nipil/atlantic-thermostat-board/LTspice/fil-pilote/capture-filpilote-arret.png

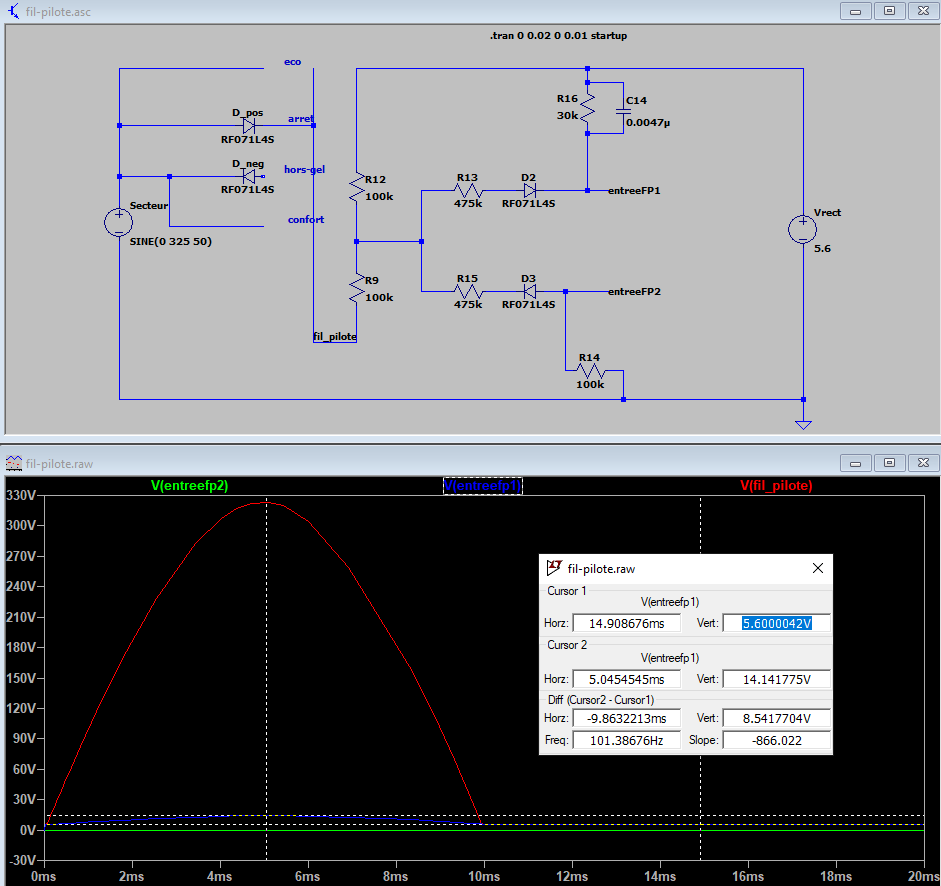
LTspice/fil-pilote/capture-filpilote-arret.png
