nipil/atlantic-thermostat-board/LTspice/fil-pilote/capture-filpilote-confort.PNG

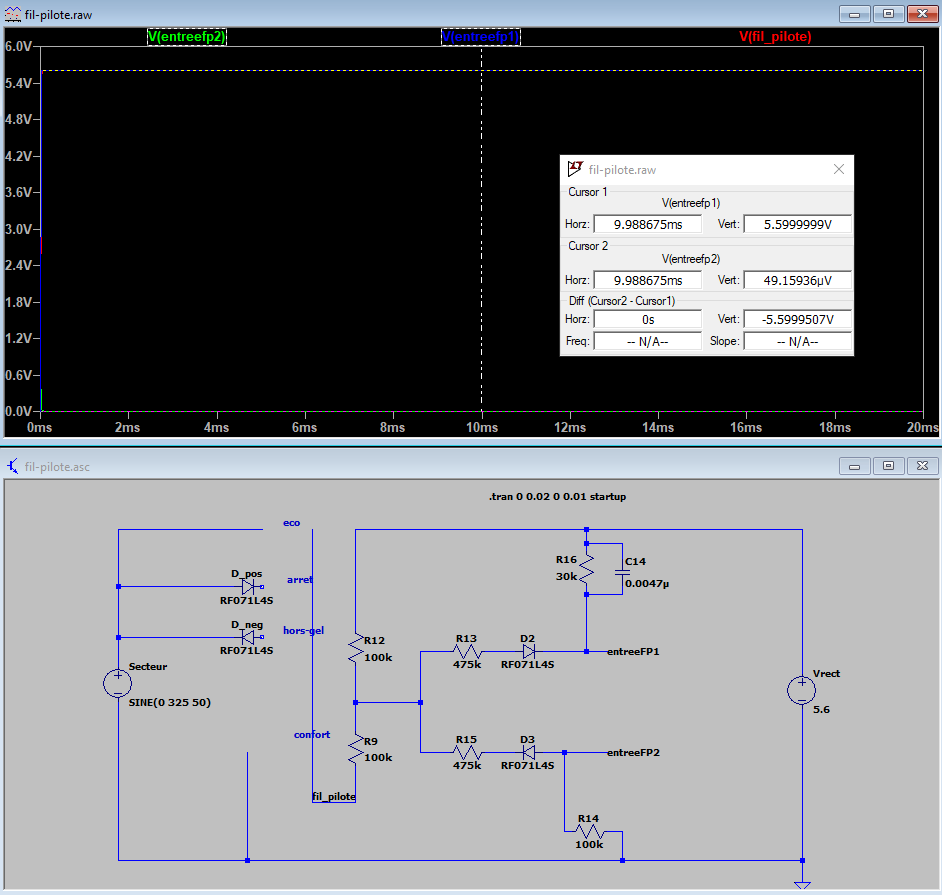
LTspice/fil-pilote/capture-filpilote-confort.PNG
