nipil/atlantic-thermostat-board/LTspice/fil-pilote/capture-filpilote-eco.PNG

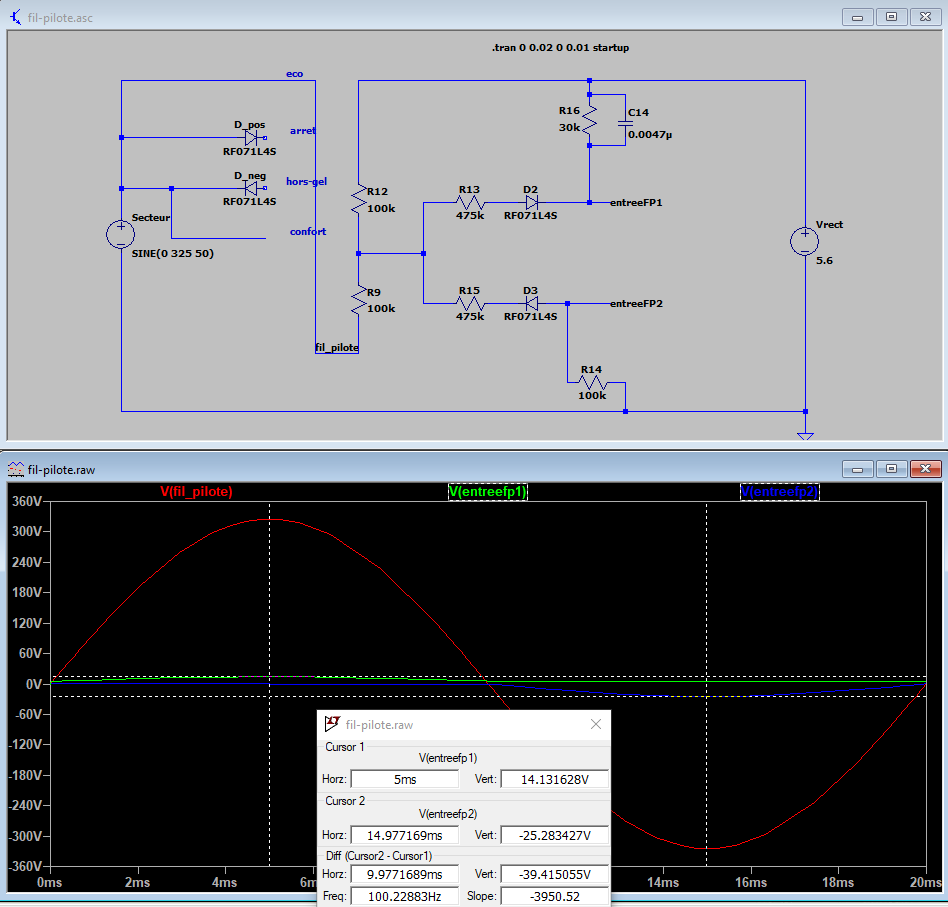
LTspice/fil-pilote/capture-filpilote-eco.PNG
