nipil/atlantic-thermostat-board/LTspice/fil-pilote/capture-filpilote-horsgel.PNG

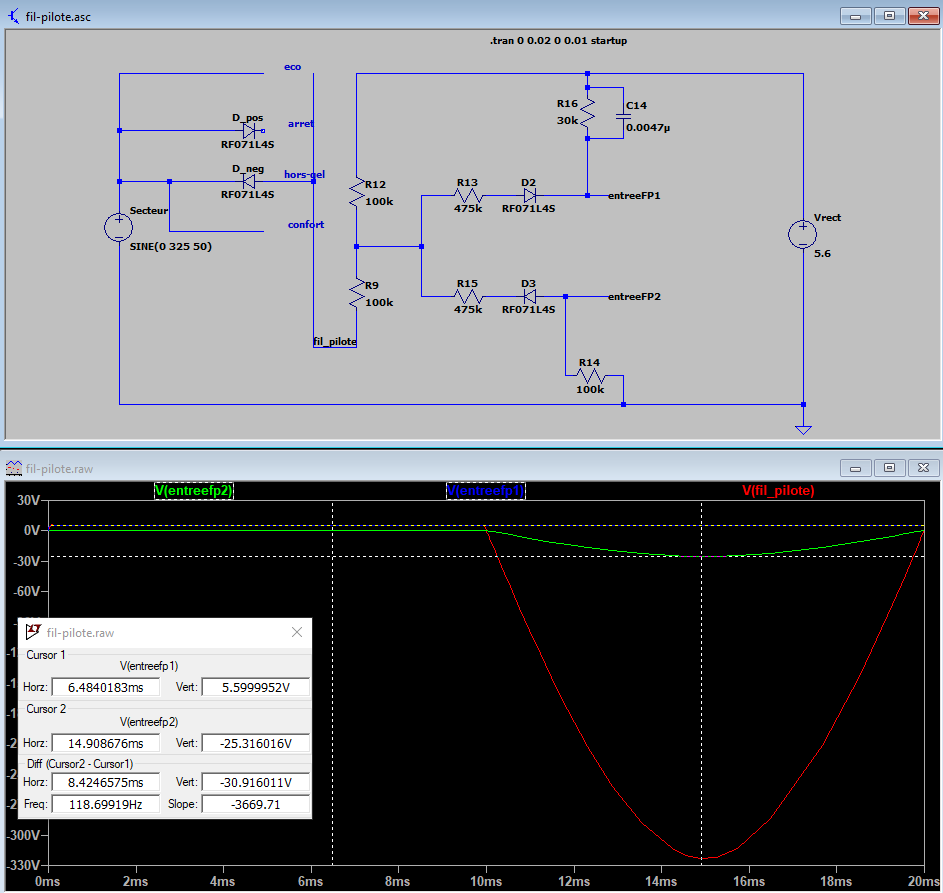
LTspice/fil-pilote/capture-filpilote-horsgel.PNG
