nipil/atlantic-thermostat-board/Photo-pistes-composants/composants-details/C1.jpg

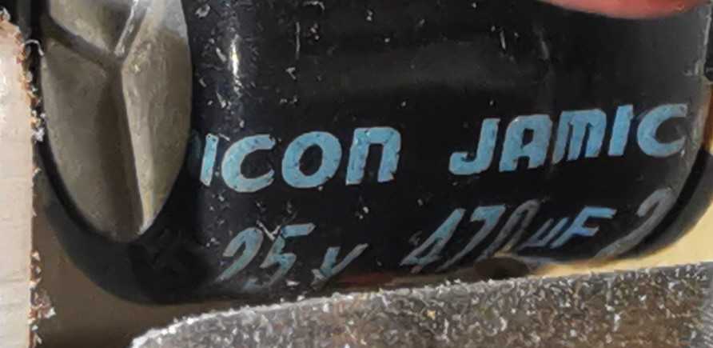
Photo-pistes-composants/composants-details/C1.jpg
