nipil/atlantic-thermostat-board/Photo-pistes-composants/composants-details/C2.jpg

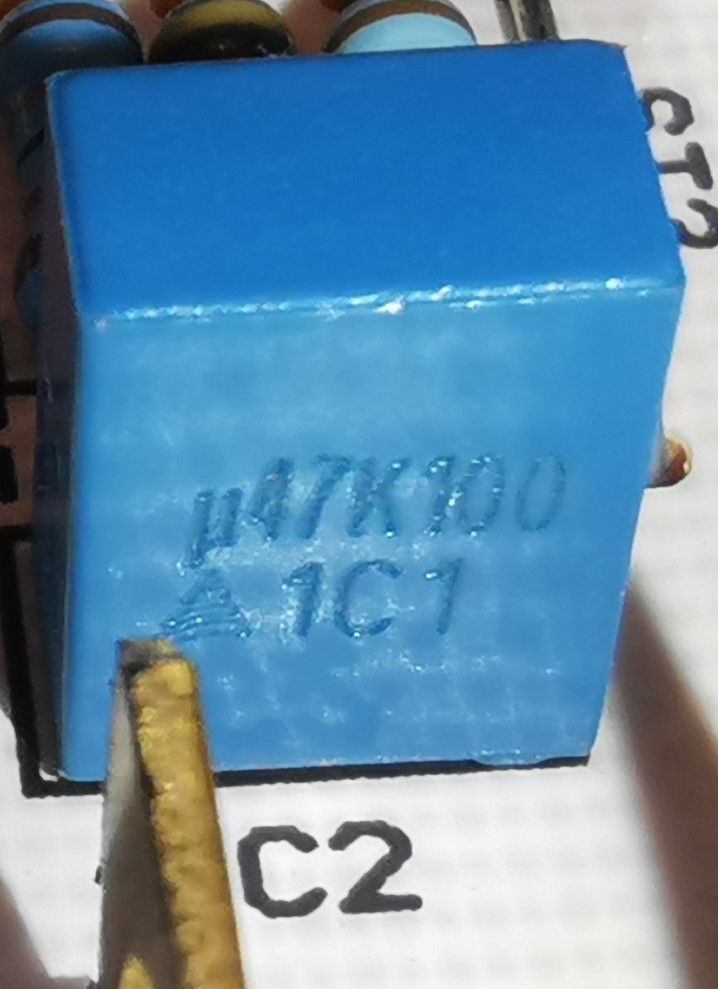
Photo-pistes-composants/composants-details/C2.jpg
