nipil/atlantic-thermostat-board/Photo-pistes-composants/composants-details/C4.jpg

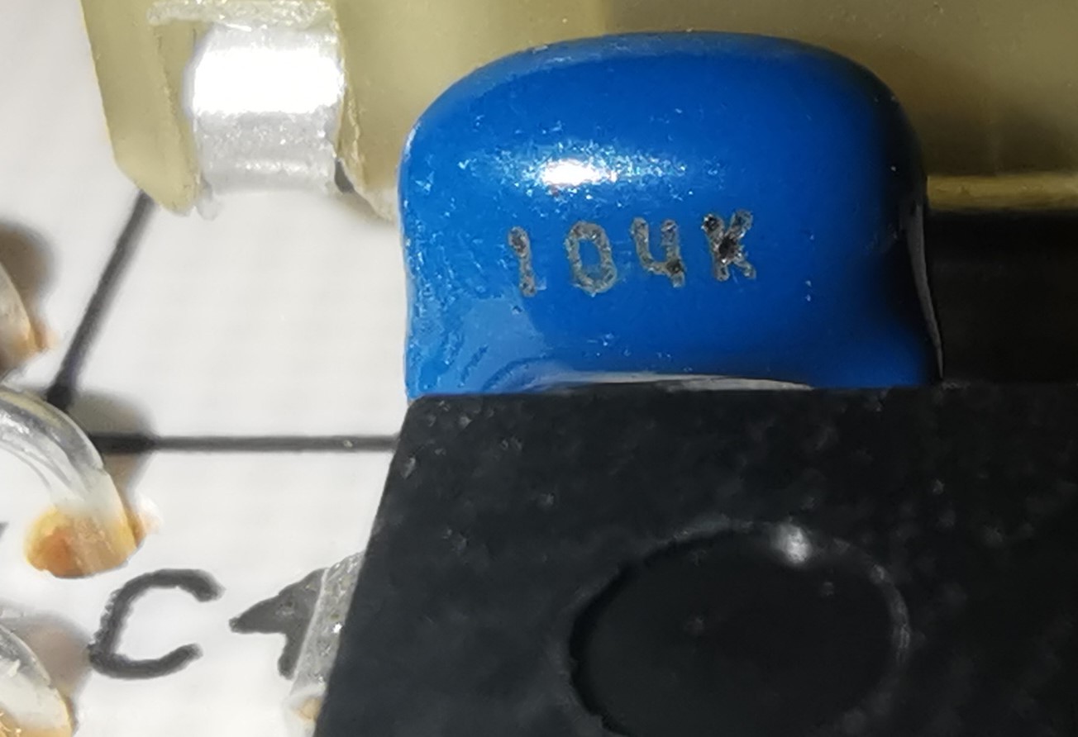
Photo-pistes-composants/composants-details/C4.jpg
