nipil/atlantic-thermostat-board/Photo-pistes-composants/composants-details/CCT1.jpg

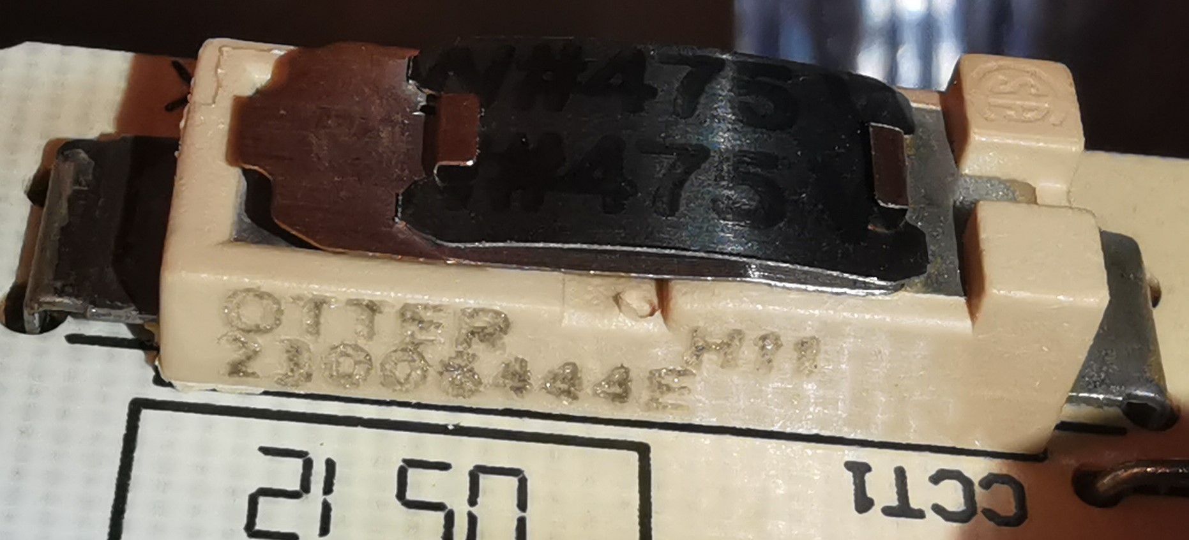
Photo-pistes-composants/composants-details/CCT1.jpg
