nipil/atlantic-thermostat-board/Photo-pistes-composants/composants-details/COMM1.jpg

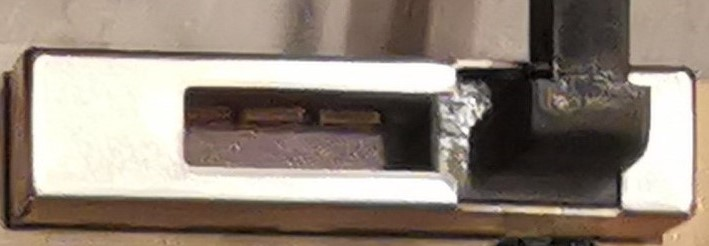
Photo-pistes-composants/composants-details/COMM1.jpg
