nipil/atlantic-thermostat-board/Photo-pistes-composants/composants-details/Cxx.jpg

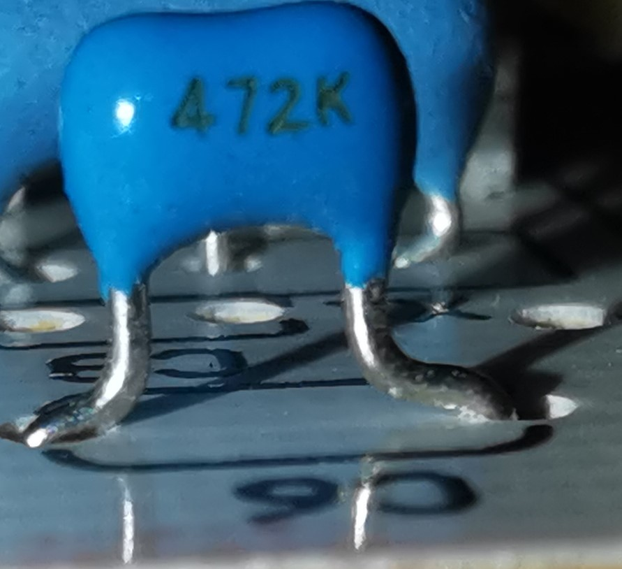
Photo-pistes-composants/composants-details/Cxx.jpg
