nipil/atlantic-thermostat-board/Photo-pistes-composants/composants-details/Dx.jpg

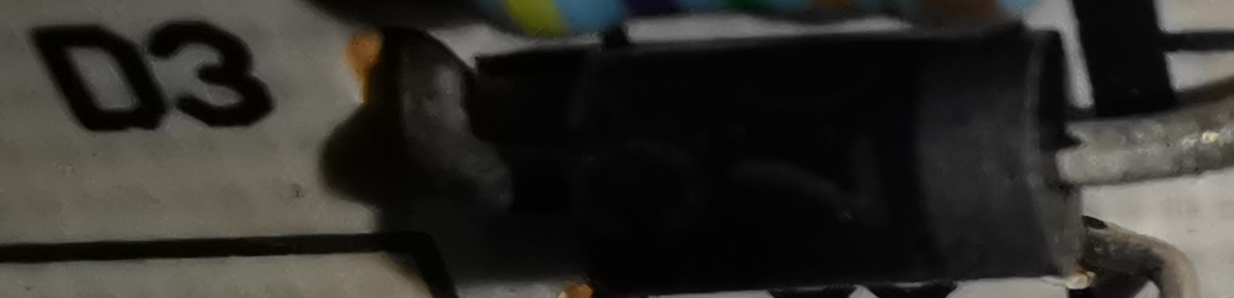
Photo-pistes-composants/composants-details/Dx.jpg
