nipil/atlantic-thermostat-board/Photo-pistes-composants/composants-details/DZ1 recto.jpg

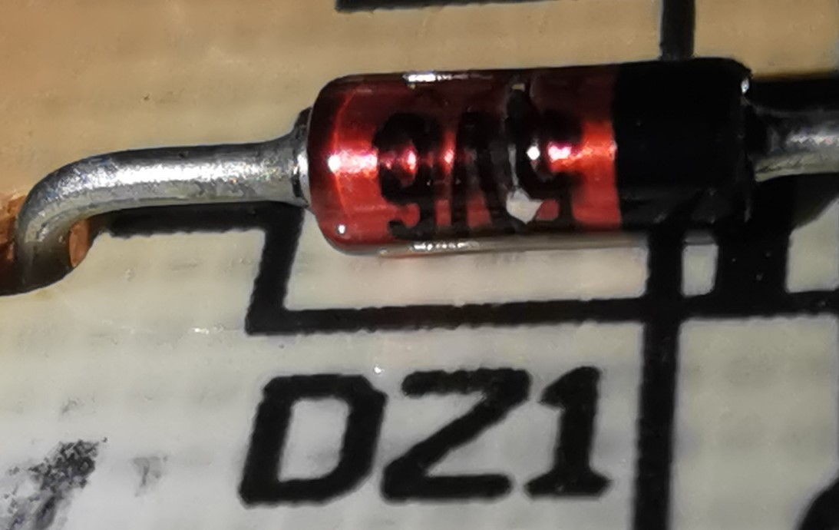
Photo-pistes-composants/composants-details/DZ1 recto.jpg
