nipil/atlantic-thermostat-board/Photo-pistes-composants/composants-details/DZ1 verso.jpg

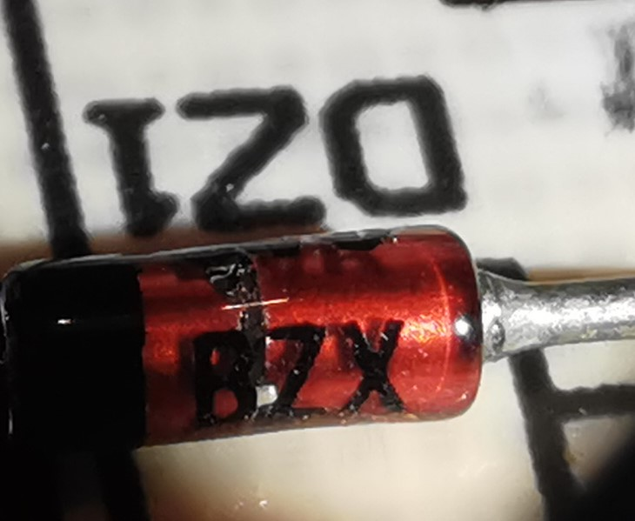
Photo-pistes-composants/composants-details/DZ1 verso.jpg
