nipil/atlantic-thermostat-board/Photo-pistes-composants/composants-details/L2-L3.jpg

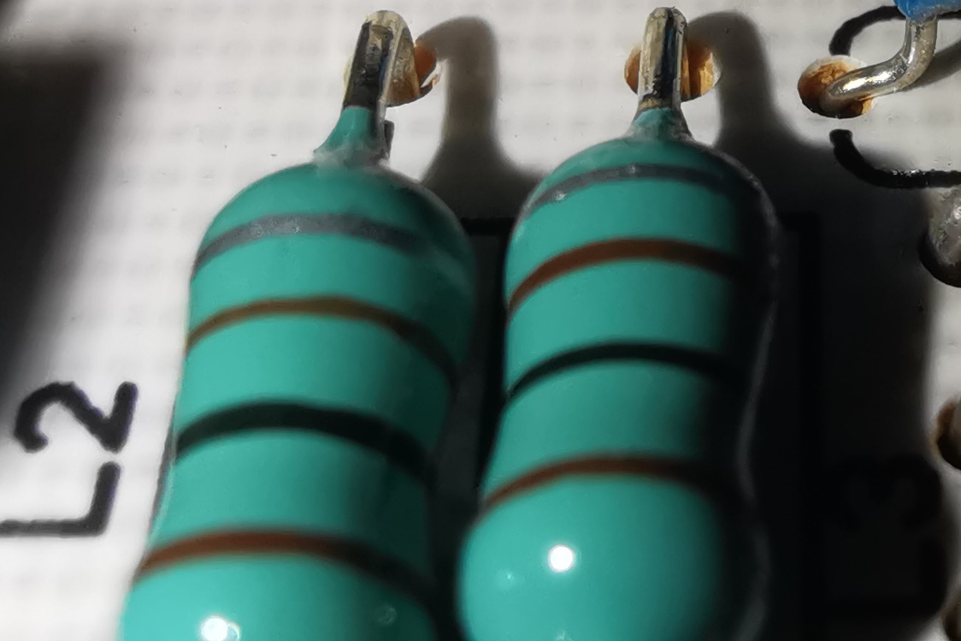
Photo-pistes-composants/composants-details/L2-L3.jpg
