nipil/atlantic-thermostat-board/Photo-pistes-composants/composants-details/POT1.jpg

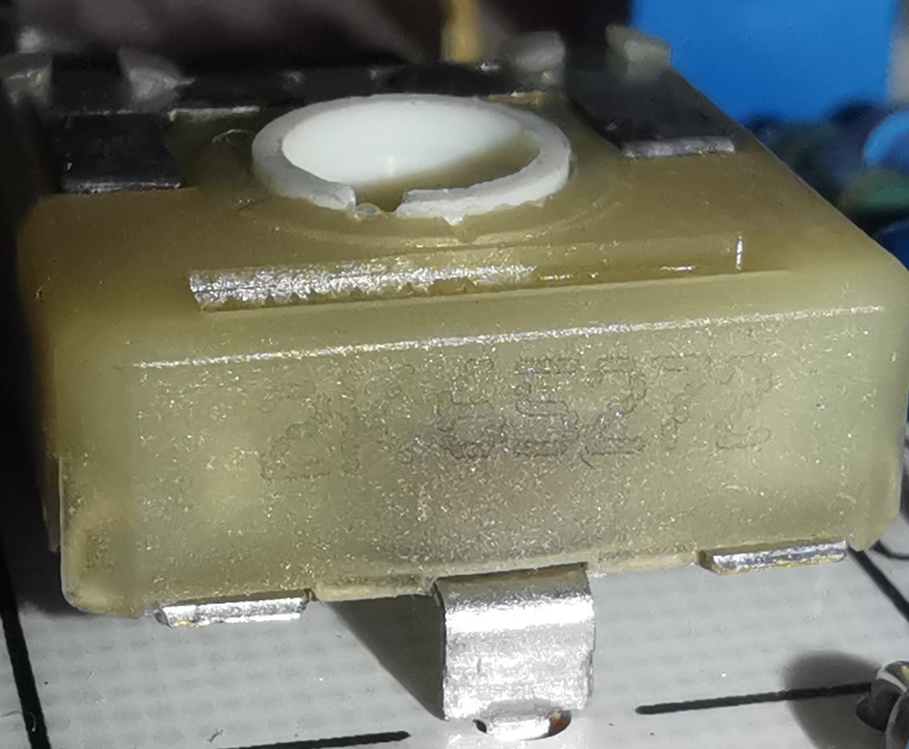
Photo-pistes-composants/composants-details/POT1.jpg
