nipil/atlantic-thermostat-board/Photo-pistes-composants/composants-details/POT2.jpg

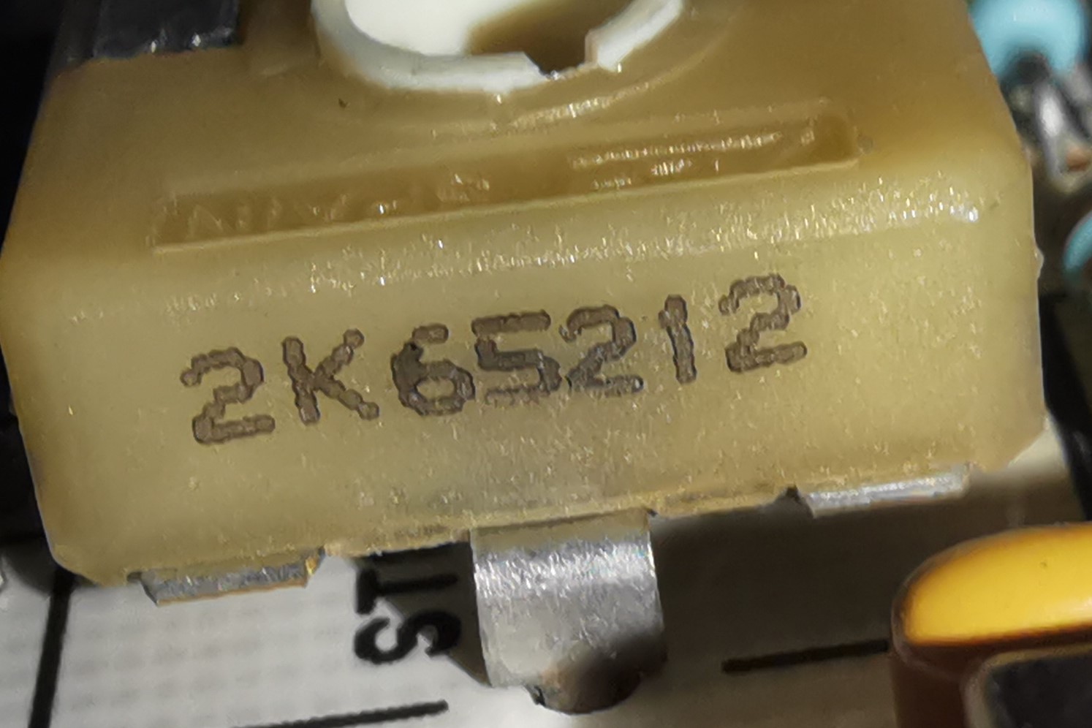
Photo-pistes-composants/composants-details/POT2.jpg
