nipil/atlantic-thermostat-board/Photo-pistes-composants/composants-details/R1-R6-R10.jpg

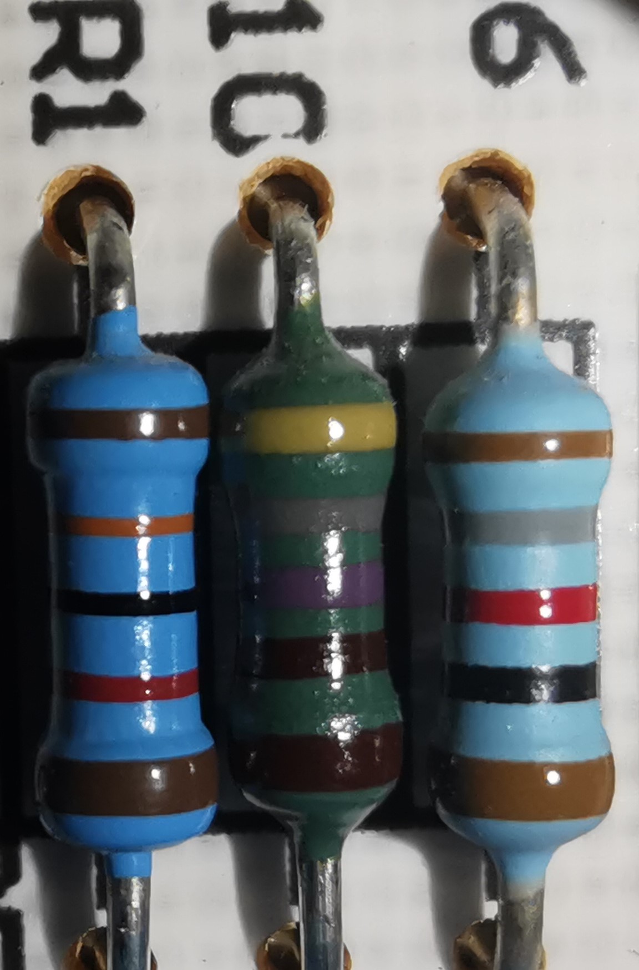
Photo-pistes-composants/composants-details/R1-R6-R10.jpg
