nipil/atlantic-thermostat-board/Photo-pistes-composants/composants-details/R2.jpg

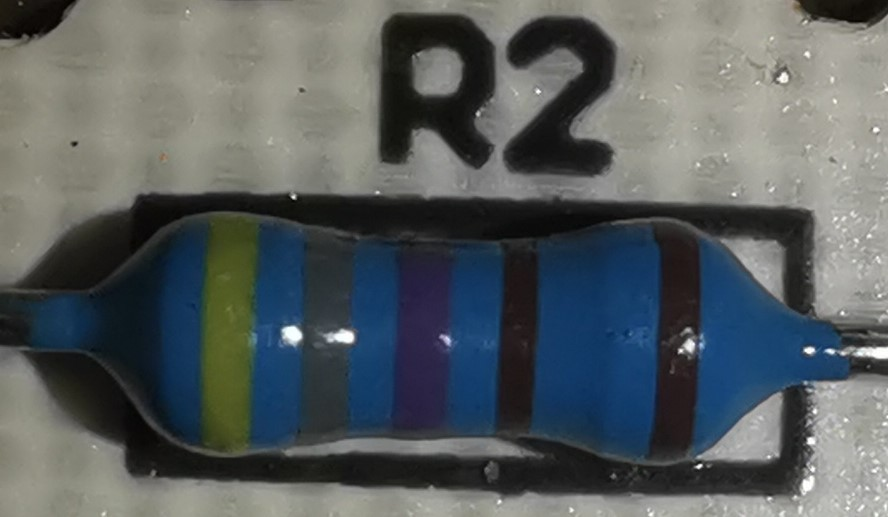
Photo-pistes-composants/composants-details/R2.jpg
