nipil/atlantic-thermostat-board/Photo-pistes-composants/composants-details/R3-R4-R7-R8-R11-R19.jpg

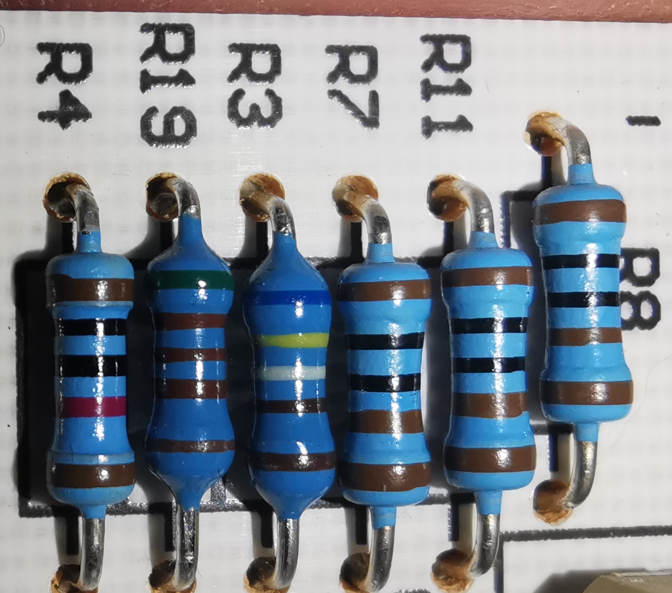
Photo-pistes-composants/composants-details/R3-R4-R7-R8-R11-R19.jpg
