nipil/atlantic-thermostat-board/Photo-pistes-composants/composants-details/R5-R9-R12-R13-R14-R15-R16-R17-R20.jpg

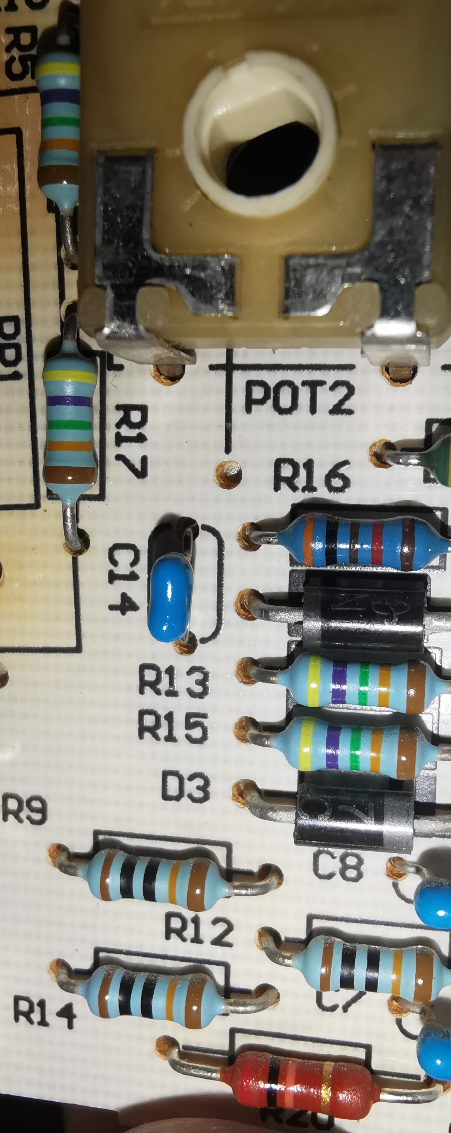
Photo-pistes-composants/composants-details/R5-R9-R12-R13-R14-R15-R16-R17-R20.jpg
