nipil/atlantic-thermostat-board/Photo-pistes-composants/composants-details/R18.jpg

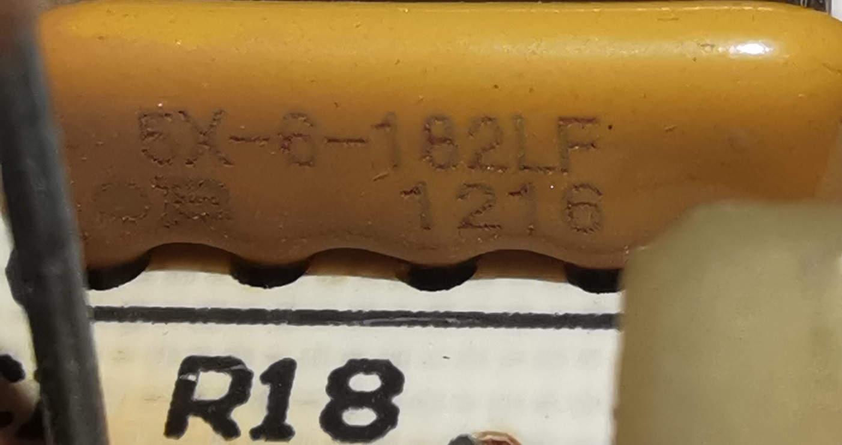
Photo-pistes-composants/composants-details/R18.jpg
