nipil/atlantic-thermostat-board/Photo-pistes-composants/composants-details/R21-R22.jpg

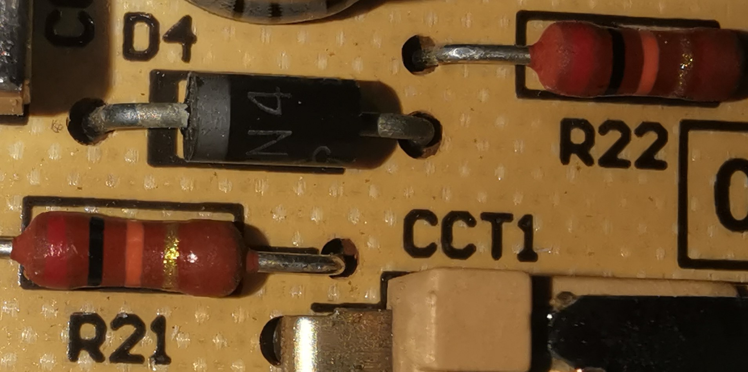
Photo-pistes-composants/composants-details/R21-R22.jpg
