nipil/atlantic-thermostat-board/Photo-pistes-composants/composants-details/RP1.jpg

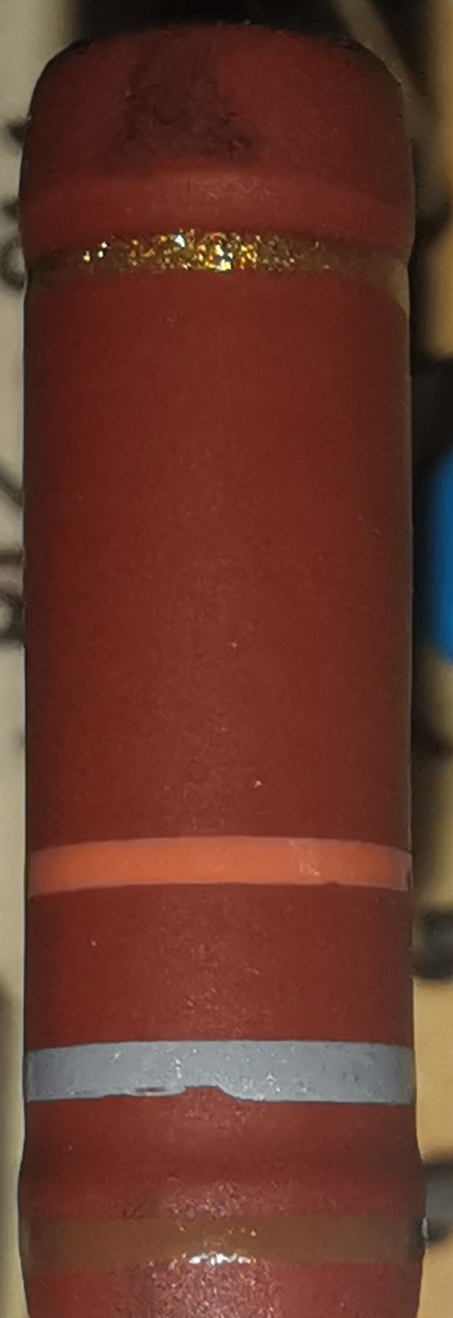
Photo-pistes-composants/composants-details/RP1.jpg
