nipil/atlantic-thermostat-board/Photo-pistes-composants/composants-details/TR1.jpg

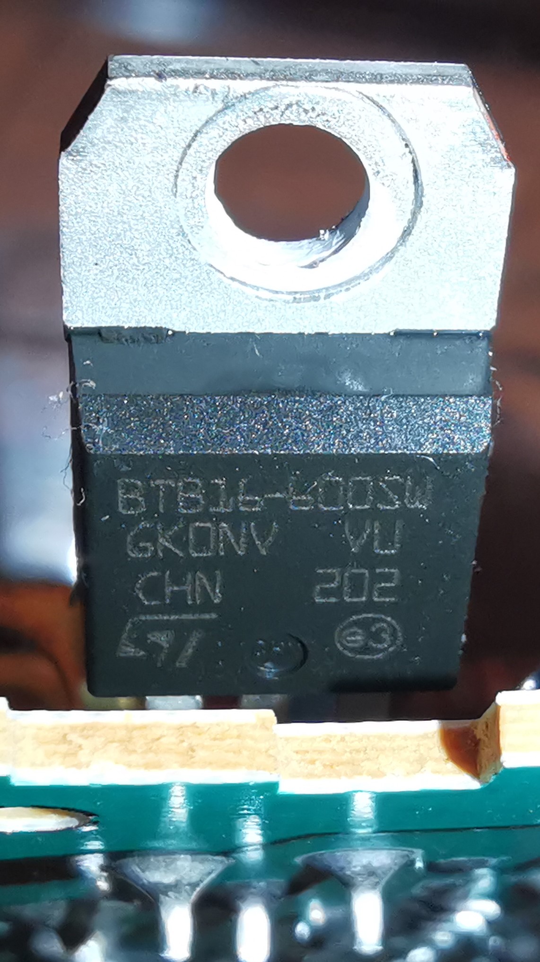
Photo-pistes-composants/composants-details/TR1.jpg
