nipil/atlantic-thermostat-board/Photo-pistes-composants/composants-details/UC1.jpg

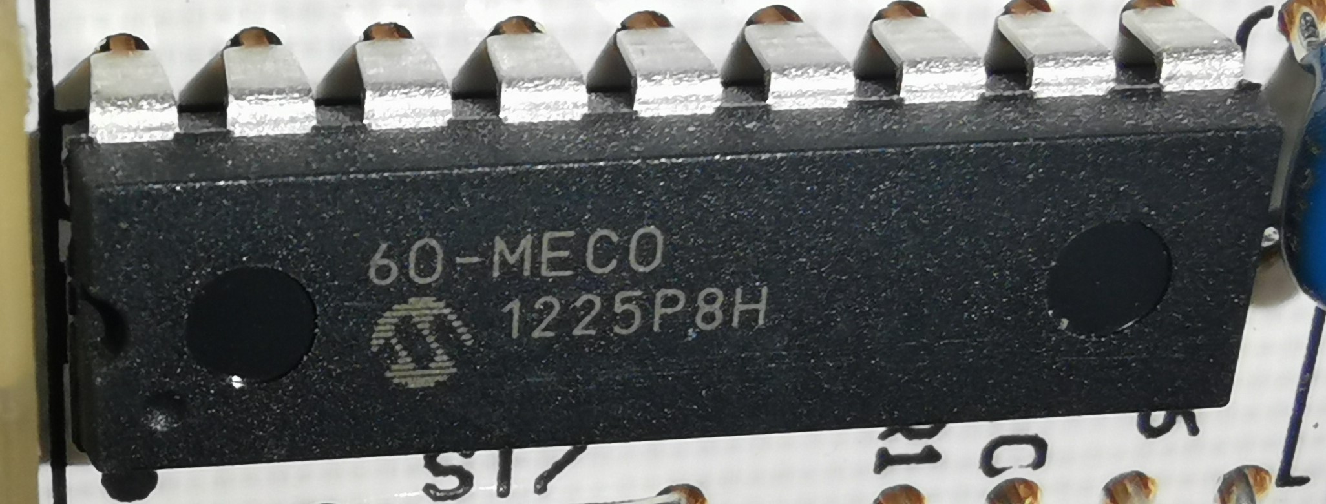
Photo-pistes-composants/composants-details/UC1.jpg
