nipil/atlantic-thermostat-board/Photo-pistes-composants/composants-details/X1.jpg

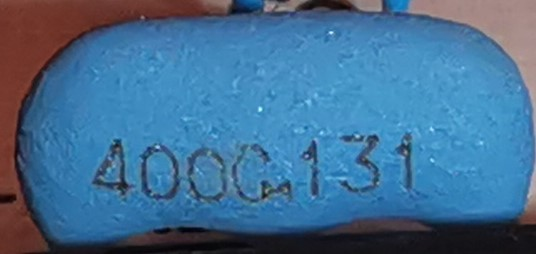
Photo-pistes-composants/composants-details/X1.jpg
