nipil/atlantic-thermostat-board/LTspice/alimentation-rectifiee/alimentation.asc

C1: polcap; 470µ; V=25 Irms=1.02 Rser=0.065 Lser=0 mfg="Nichicon" pn="UPL1E471MPH" type="Al electrolytic"
C3: cap; 0.0047µ; V=250 Irms=0 Rser=0 Lser=0 mfg="Murata" pn="GCM31A5C2E472JX01" type="C0G"
C4: cap; 0.1µ; V=200 Irms=940m Rser=0.0607607 Lser=0 mfg="KEMET" pn="C1825C104K2RAC" type="X7R"
C6: cap; 0.0047µ; V=250 Irms=0 Rser=0 Lser=0 mfg="Murata" pn="GCM31A5C2E472JX01" type="C0G"
C10: cap; 0.0047µ; V=250 Irms=0 Rser=0 Lser=0 mfg="Murata" pn="GCM31A5C2E472JX01" type="C0G"
D1: diode; 1SR154-400
DZ1: zener; BZX84B6V2L
Mains: voltage; SINE(0 320 50)
R1: res; 18.0K; tol=5 pwr=3
R7: res; 1K; tol=1 pwr=0.1
Named nets: 0, Vin, Vout
.tran 0 5 0 0.001 startup
