nipil/atlantic-thermostat-board/LTspice/fil-pilote/fil-pilote.asc

C14: cap; 0.0047µ; V=630 Irms=261m Rser=0.9428 Lser=0 mfg="KEMET" pn="C0805C472KBRAC" type="X7R"
D2: diode; RF071L4S
D3: diode; RF071L4S
D_neg: diode; RF071L4S
D_pos: diode; RF071L4S
R9: res; 100k; tol=1
R12: res; 100k; tol=1
R13: res; 475k; tol=1
R14: res; 100k; tol=1
R15: res; 475k; tol=1
R16: res; 30k; tol=1
Secteur: voltage; SINE(0 325 50)
Vrect: voltage; 5.6
Named nets: 0, entreeFP1, entreeFP2, fil_pilote
eco
confort
hors-gel
arret
.tran 0 0.02 0 0.01 startup
