nipil/atlantic-thermostat-board/(list of files, drawings)

Other design files:
Schematic-EasyEDA/Carte thermostat.json
