nipil/atlantic-thermostat-board/(commit log)

2021-03-28 déplacement des schémas EasyEDA dans le répertoire dédié
    [Carte thermostat.json]
2021-03-28 Ajout de l'analyse des traces et composants par fonction avec calques
2021-03-28 ajout de quelques datasheet significatives
2021-03-28 ajout de la liste détaillée des composants
2021-03-28 ajout des photos des composants de la carte
2021-03-28 ajout des photos d'ensemble pour inclusion dans le README
2021-03-28 ajout des miniatures
2021-03-28 Ajout de la prévisualisation
2021-03-28 inclusion des composants dans le README
2021-03-28 Reprise de l'image ayant la plus grande résolution
2021-03-28 Ajout du schémas de la partie alimentation de la carte
2021-03-29 ajoute d'infos sur les diodes
2021-03-29 Schémas de la platine découpé par fonction
    [Carte thermostat.json]
2021-03-29 ajout de l'apercu de l'analyse de la carte
2021-03-29 update de la doc pour ajouter l'aperçu du schémas EasyEDA
2021-03-30 ajout de la simulation du fil pilote
2021-03-30 ignore les fichiers graphes
2021-03-30 déplacement de la partie alimentation/rectification dans un dossier
2022-06-03 Ajout des informations sur le courant dans le fil pilote
